petarturukalo/micro-guitar-tuner/test/data/note/README.md

Recordings (recorded with Audacity) of open string guitar notes (tuned 
relative to standard) for testing. Open string notes are used because 
the main use case of the tuner is to get the open strings in tune. 
See comments at `../../../core/note.c:note_freqs` for more info on the 
range of notes being tested.

Each file contains digital audio of a single note on the guitar, 
the note being named in the filename. File format is 4 oversized frames 
(oversize frame length 8192 samples) of raw (headerless), uncompressed, 
mono, 8000 Hz oversample rate, signed 16-bit PCM audio.
