petarturukalo/micro-guitar-tuner/(commit log)

2024-02-18 change sample rate of test data to 4096 Hz
2024-02-18 generate filter coefficients with gnu octave script
2024-02-20 gen filter coefficients
    - decrement order so number of taps is 2000
    - print coefficients as 32-bit floats because that's their datatype when copied into .c
    - output coefficients across multiple lines in a tabular format
2024-03-03 tests for HPS
    - fix up understanding of bin frequency ranges and HPS implementation
    - add tests binary for assertion tests
    - generalise note file source to just file source so sine wave tests can reuse its functionality
    [dsp.c, note.c]
2024-03-10 add pico-sdk submodule
2024-03-11 bare minimum working mcu microphone
    - add mcu/ dir for pico code
    - refactor libcore to take target cpu, required to work on pico
2024-03-13 processing core first stage
    - only include ARM FFT tables used to reduce final executable size dramatically
    - refactor samples_to_freq_bin_magnitudes() to take either signed 16-bit ints (needed by test) or 32-bit floats (needed by mcu)
2024-03-13 easily configurable filter order / number taps
    - make the filter order / number of coefficients easier to change by generating the filter coefficients C table automatically. needed because the filter is a bottleneck for the mcu processing core
    - have test and mcu build their own version of the core lib with differently named objects so they don't conflict with each other
2024-03-15 working guitar tuner
    - change number of taps to meet < 1 second processing core requirement
    - update filter comments to reflect change in number of taps
    - separate dsp init out into its own function because the filter uses stateful data that should only be initialised once
2024-04-26 resolve comment documentation TODOs
    [guitar_tuner.c]
2024-04-26 resolve core init synchronisation TODO
    [guitar_tuner.c]
2024-04-29 deep sleep power saving
    - configure clocks to save power when sleeping
    - note won't save much power until the processing core processing time speeds up
    [guitar_tuner.c]
2024-05-25 port from pico to stm32
    - change note test data from 4 seconds of 4096 Hz sample rate to 4 frames of 4000 Hz sample rate
    - change sine test data to 4000 Hz sampling rate and its tests to test the new bin width
    - change oversampling rate from 4096 to 4000 because it's easier to divide a clock to it on stm32
    - change bin_width() return to float because change in oversampling rate gives a non-integer bin width
2024-05-25 move samples_to_freq_bin_magnitudes_s16() out of core to test
    - since only test uses it and it wastes MCU RAM space
    - also resolve a couple TODOs
    [dsp.c, guitar_tuner.c]
2024-05-25 resolve unused frame lengths TODO
    [dsp.c]
2024-05-25 fix up nr taps comment since using stm32 instead of pico
2024-05-25 resolve frequency/time resolution TODOs
    [guitar_tuner.c]
2024-05-25 change comment referencing pico
2024-05-26 use slowest apb clocks to save power
2024-05-26 add comment explaining time to fill frame of samples and process them
2024-05-26 resolve noise floor TODO
    [guitar_tuner.c]
2024-05-26 rm printf debugs
2024-05-30 reword readme power section intro
2024-05-30 power wording
2024-06-01 resolve reference to resources TODOs
    [dsp.c]
2024-06-16 fix adc comment
2024-06-26 remove P prefix from PB8 and PB9 pin names
2024-06-29 fix anti-alias filter
    - fix lowpass/anti-alias filter by properly oversampling and then applying the filter before decimating down to the regular sampling rate
    - update README DSP section to reflect oversampling changes
    - up sampling rate of test data to the oversampling rate
    [dsp.c, guitar_tuner.c, note.c]
2024-06-29 add anti-alias filter tests
    - break down test/data/sine/ dir into subdirs to organise sine wave test data better
    - expose for_each_file_source() to header and remove its wrappers from header, to accommodate new subdirs in test/data/sine/
2024-06-29 fix readme which MCU board pins go to which display I2C pins
2024-06-30 add i2c
